XJH-Jorhai/asterx-m3-proplus-carrierboard/_ethernet_ref_page-18.png

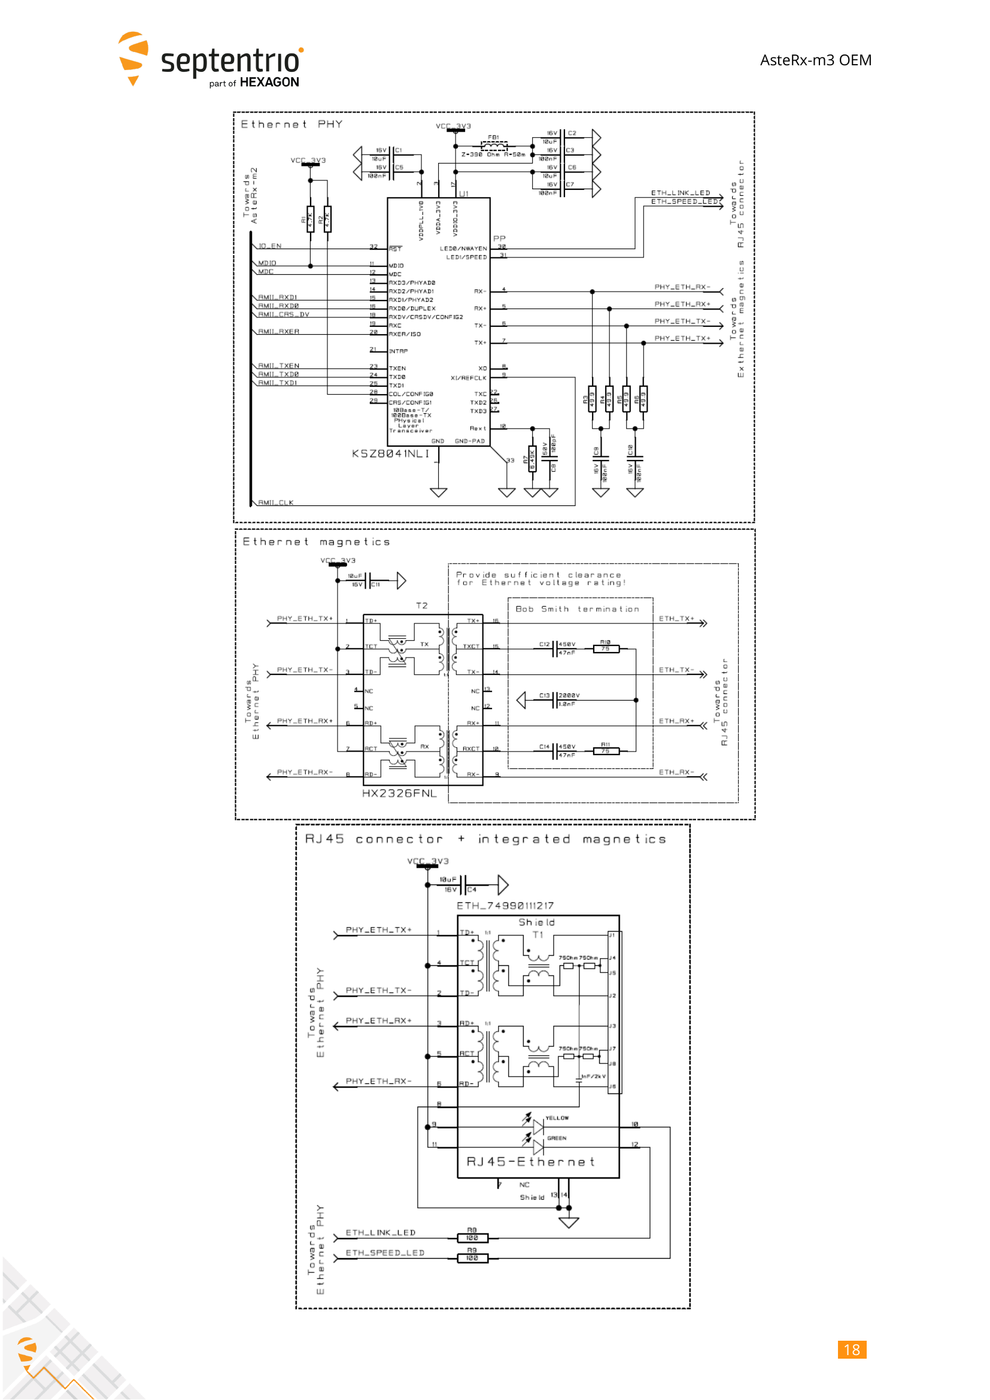
_ethernet_ref_page-18.png
