XJH-Jorhai/asterx-m3-proplus-carrierboard/(list of files, drawings)

Other design files:
easyeda_exports/agent_netlist_summary_2026-05-02.json
