XJH-Jorhai/asterx-m3-proplus-carrierboard/(commit log)

2026-04-28 Add AsteRx carrierboard design docs
    [AsteRx-m3_ProPlus_器件选型清单_定稿.csv, asterx_m3_proplus_carrier_feature_boundary.csv]
2026-05-01 sync schematic docs
    [AsteRx-m3_ProPlus_器件选型清单_定稿.csv, asterx_m3_proplus_carrier_feature_boundary.csv]
2026-05-01 Sync schematic docs and netlist cache
    [TPS25947xx_Design_Calculator.xlsm, TPS2663x _TPS1663x_Design_Calculator_revB.xlsx, agent_netlist_summary_2026-05-02.json]
